emirhan-yasar/micro-air-conditioner-circuit/Figures/Plots/MEASURED/1.jpg

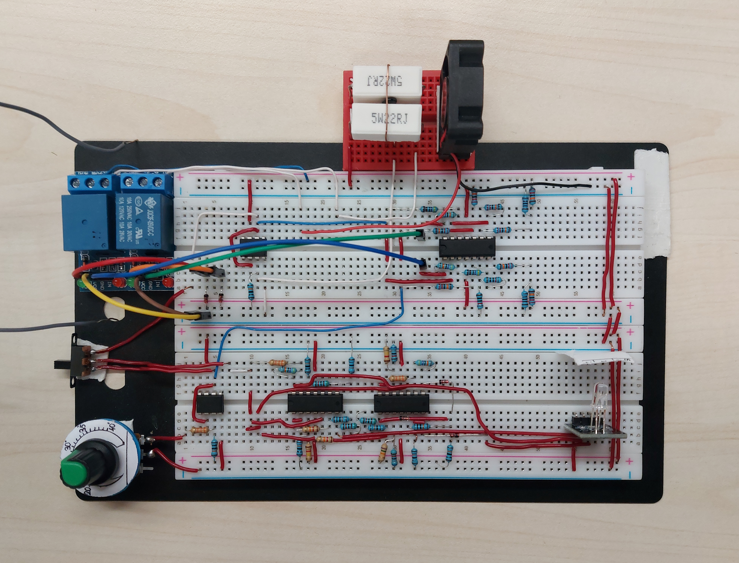
Figures/Plots/MEASURED/1.jpg
