emirhan-yasar/micro-air-conditioner-circuit/Figures/Circuit_Designs/Circuit_Designs.pdf

# Micro Air Conditioner Circuit – Designs

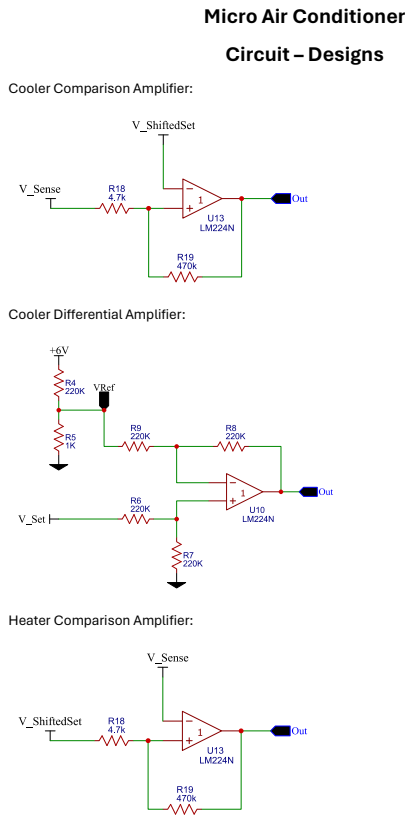
[picture p20: page 1]

Cooler Comparison Amplifier:

Cooler Differential Amplifier:

Heater Comparison Amplifier:

# Heater Summing Amplifier:

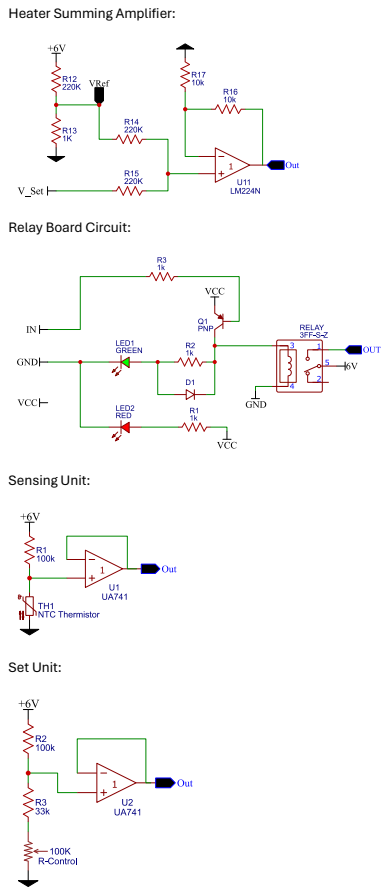
[picture p21: page 2]
Sensing Unit:; Set Unit:

Relay Board Circuit:

# Display Unit (Blue) Circuit:

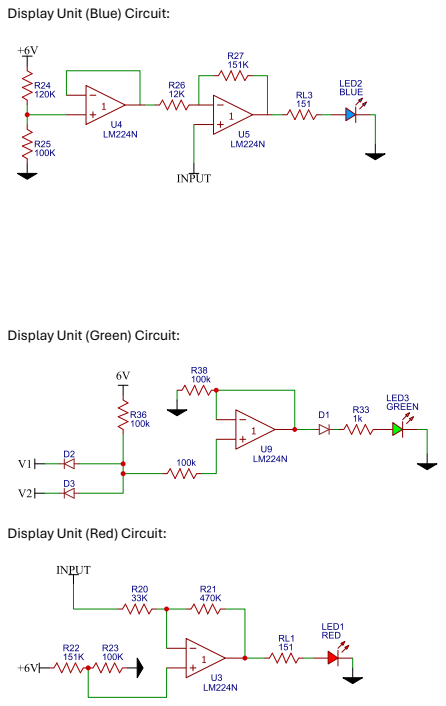
[picture p22: page 3]

Display Unit (Green) Circuit:

Display Unit (Red) Circuit:

# LTSpice Circuits:

# Sensing Unit:

# Set Unit:

U1

LM224

R1
100k

# NTC

# R = {Rr}*exp({B} * (1/(temp+273) - 1/{Tr}))

V1

6⁶V | 6V

# Vout ⁶V .param Rr = 100k

# .param B = 3950

# .param Tr = 298

# .dc temp 20 44 0.1

# Sensing Unit

# Mustafa Emirhan Yaşar - 2517191 Orhan Akarkut - 0018713

# Rr = 100k (ohm)

B = 3950 (K)

# Tr = 298 (K)

# Rt = Rr * exp(1/T - 1/Tr)

U1

LM224

R4
100k

# R-Control R = {pot}

V1

6

R1

33k ⁶V | 6V

# Vout

.step param pot 100k 1e-6 1k | 6V

.op

# .options NoOpIter .options GminSteps=0 .options SrcSteps=0 .options pTranTau=0

# Set

# Mustafa Emirhan Yaşar - 2517191 Orhan Akarkut - 0018713

# Control Unit:

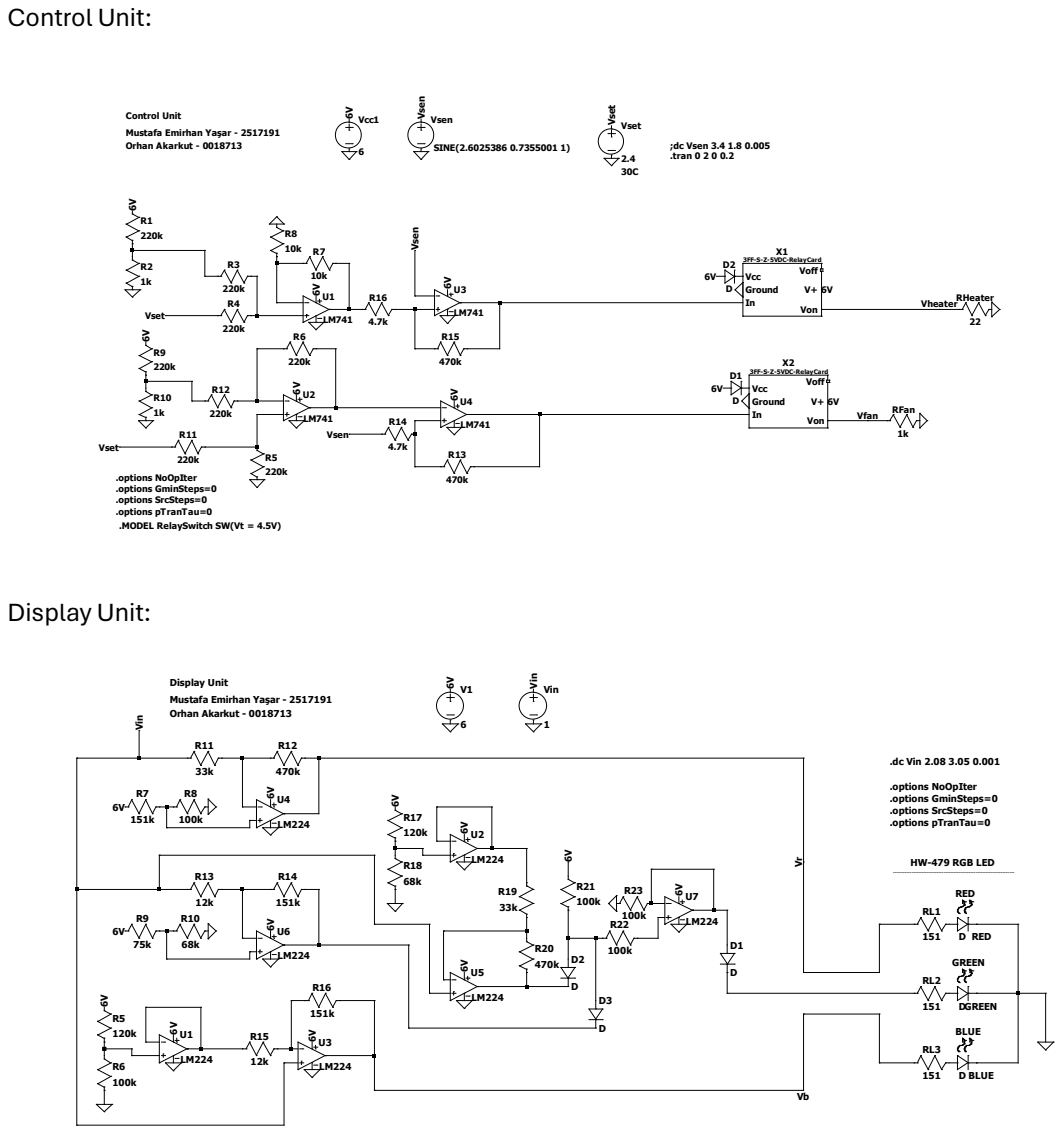
[picture p23: page 5]

.options NoOpIter
.options GminSteps=0
.options SrcSteps=0
.options pTranTau=0
.MODEL RelaySwitch SW(Vt = 4.5V)
