emirhan-yasar/micro-air-conditioner-circuit/LTSpice/3FF-S-Z-5VDC-RelayCard.asc

D1: diode
Green1: LED
JQF1: sw; RelaySwitch
Q1: pnp
R1: res; 100
R2: res; 1k
R3: res; 1k
R4: res; 1k
Red1: LED
Named nets: In, Ground, Vcc, V+, Von, Voff
.MODEL RelaySwitch SW(Vt = 4.5V)
